Nanqi-mo/Fly_Car-Project/(list of files, drawings)

Other design files:
Fly_Car_project_硬件开源部分/P3+KG.epro
Fly_Car_project_硬件开源部分/ProPrj_DRV8701 - 副本_2026-07-18.epro
