Nanqi-mo/Fly_Car-Project/(commit log)

2026-10-11 上传飞行汽车项目资料：硬件工程、软件代码及文档
    [P3+KG.epro, ProPrj_DRV8701 - 副本_2026-07-18.epro]
2026-10-11 新增设计说明书
2026-10-11 新增README项目说明
2026-10-11 更新README：新增获奖证书、详细致谢与开源说明
2026-10-11 精简致谢段落，去除具体人名，委婉化开源说明
2026-10-11 完善README文档
2026-10-12 更新说明书，新增系统架构、控制框图与模式切换示意图
2026-10-12 优化README排版，增加项目徽章
2026-10-12 修正主控型号为SR6P3C4
